Tony-Computer-Science/IoT-Security-Gateway/docs/assets/s3-test/hardware-events.png

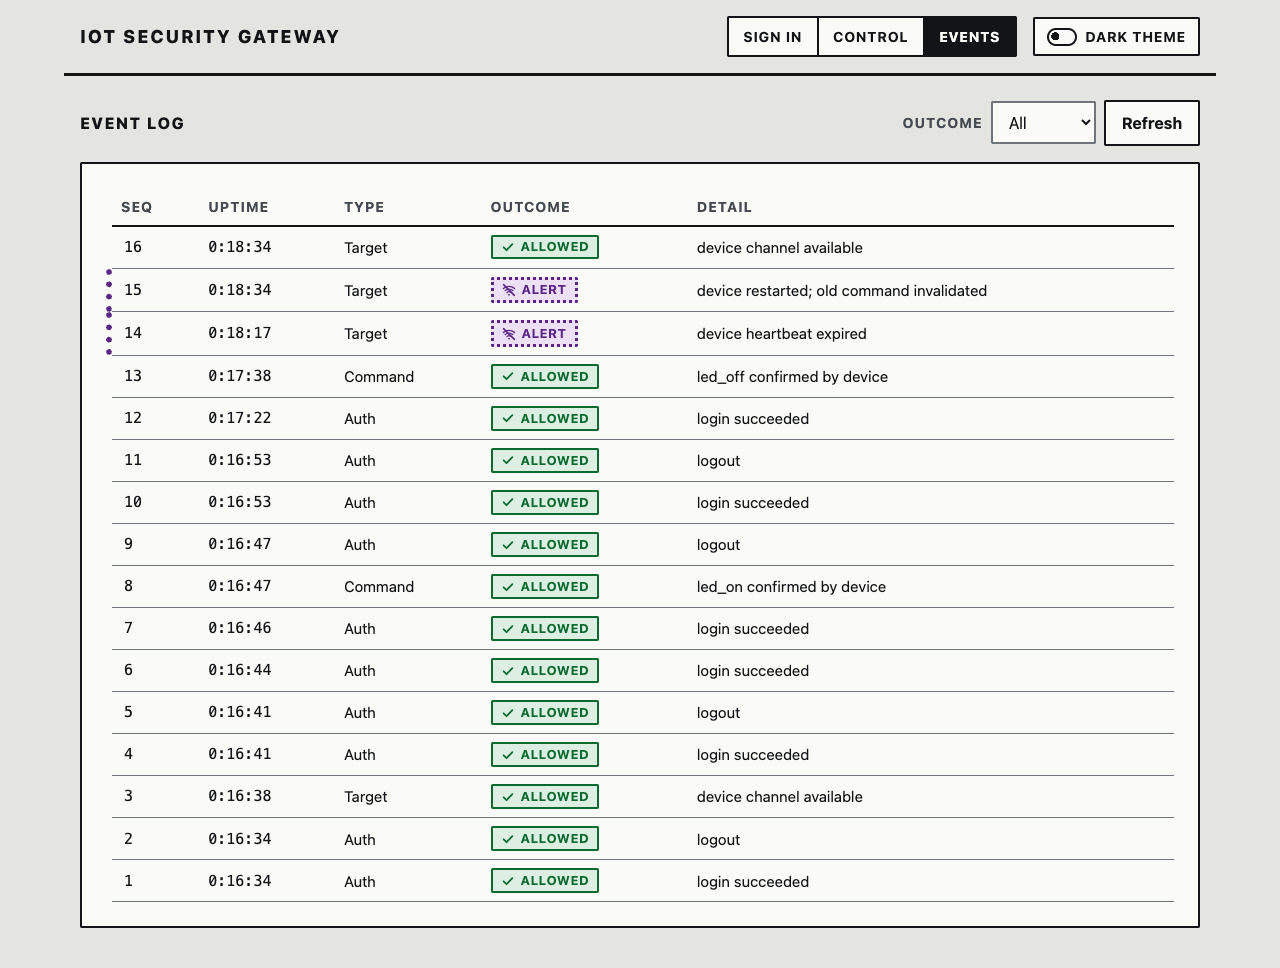
docs/assets/s3-test/hardware-events.png
