Tony-Computer-Science/IoT-Security-Gateway/docs/assets/s3-test/hardware-heartbeat-expired.png

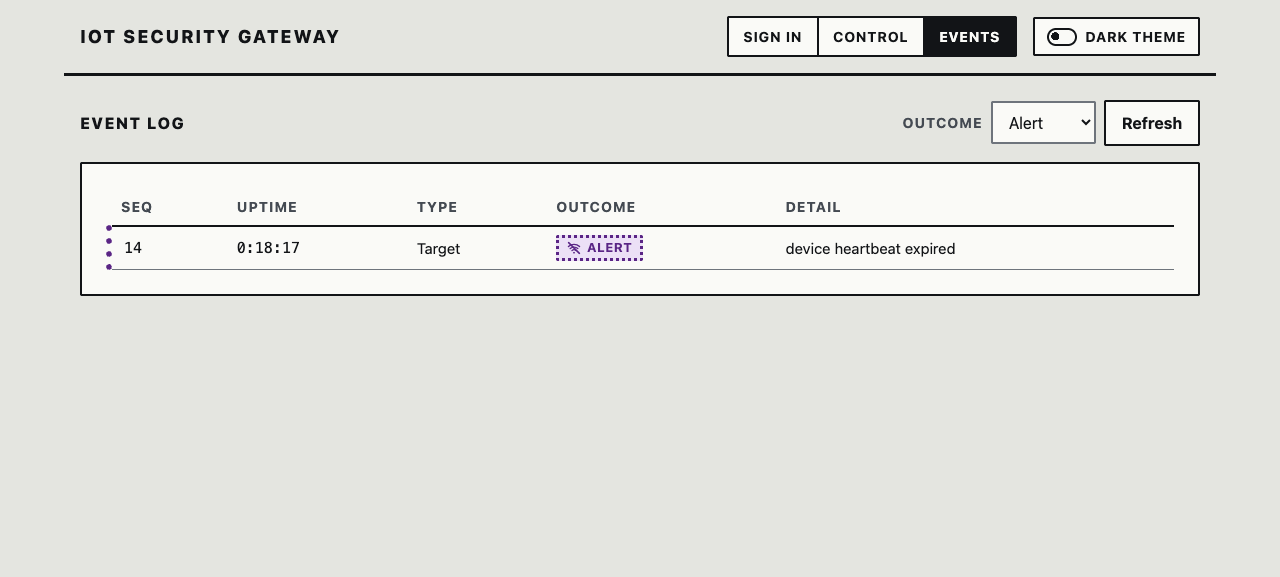
docs/assets/s3-test/hardware-heartbeat-expired.png
