Tony-Computer-Science/IoT-Security-Gateway/docs/assets/s3-test/hardware-online.png

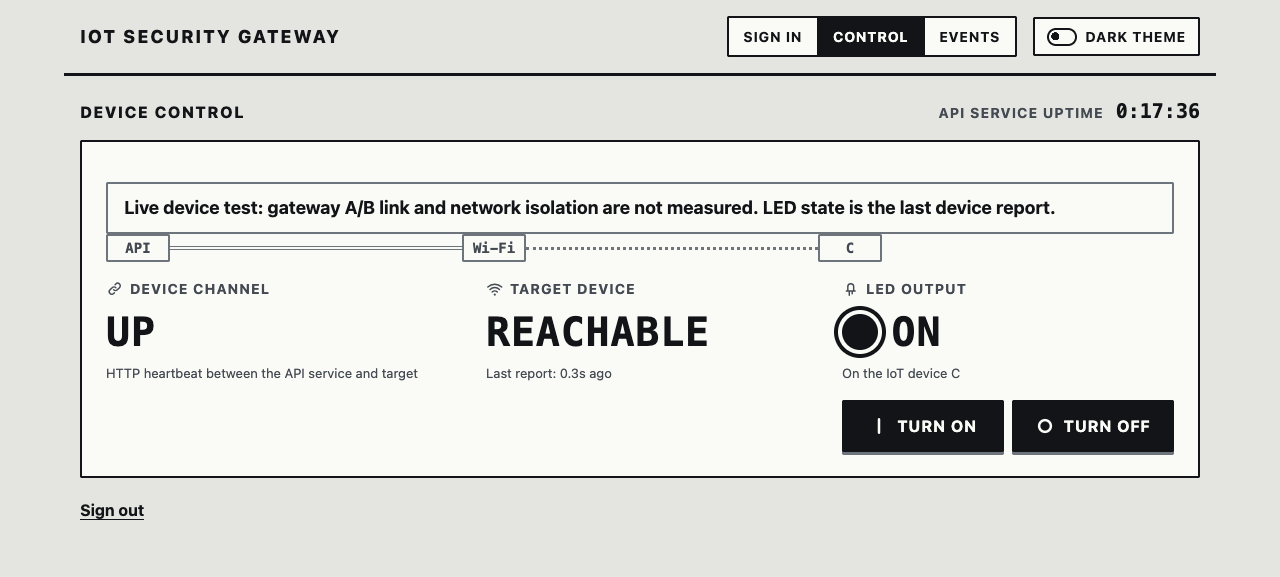
docs/assets/s3-test/hardware-online.png
