Tony-Computer-Science/IoT-Security-Gateway/docs/assets/s3-test/live-monitoring-offline.png

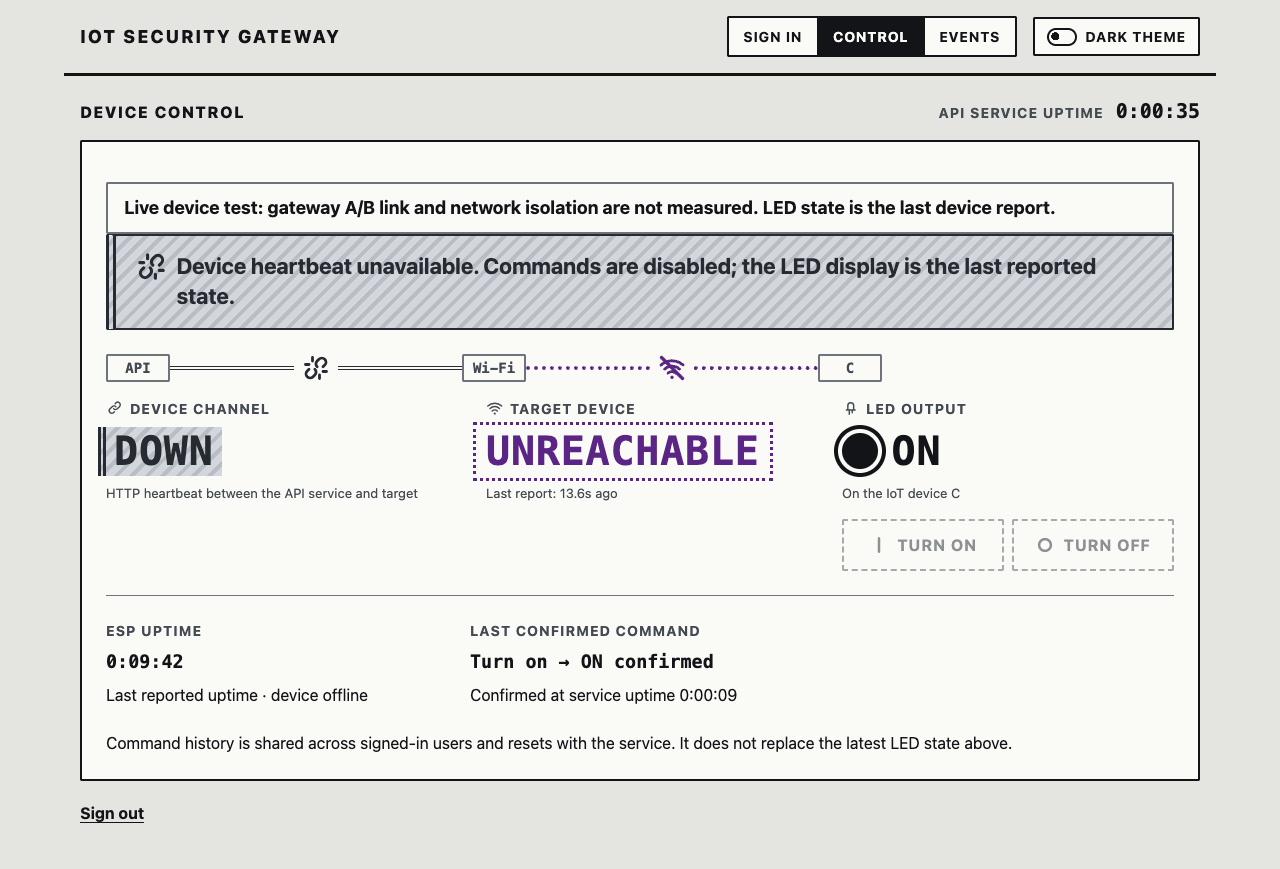
docs/assets/s3-test/live-monitoring-offline.png
