Tony-Computer-Science/IoT-Security-Gateway/docs/assets/s3-test/live-monitoring-restart.png

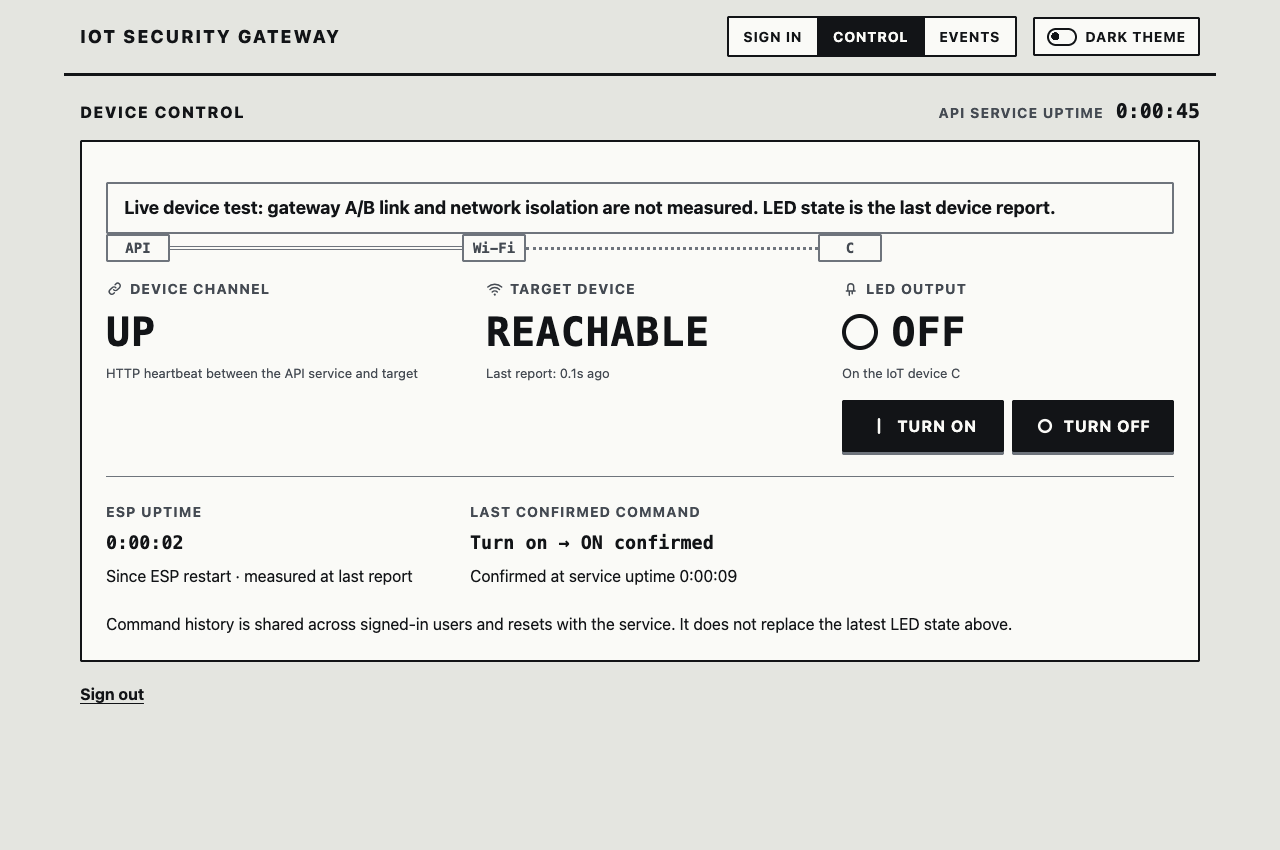
docs/assets/s3-test/live-monitoring-restart.png
