Tony-Computer-Science/IoT-Security-Gateway/hardware/kicad/IoT-Gateway.kicad_pcb

## KiCad design hardware/kicad/IoT-Gateway.kicad_pcb (2026-10-25)

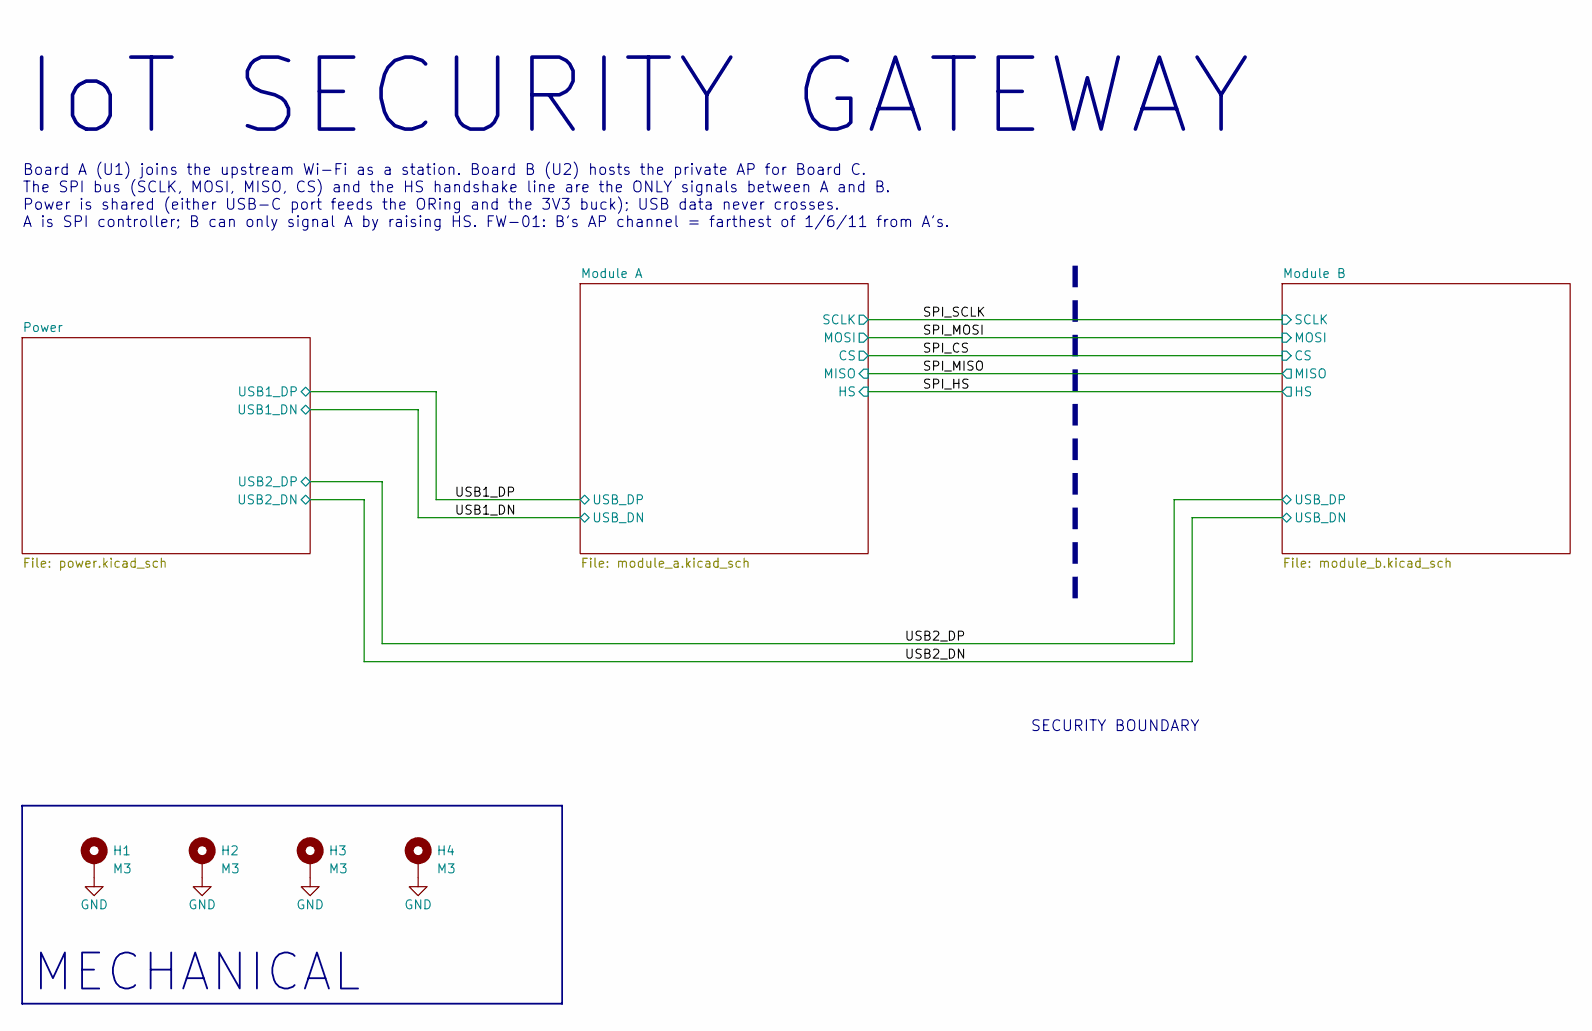
[picture p6: schematic IoT-Gateway.kicad_sch, IoT Security Gateway]

Parts:
H1, H2, H3, H4: M3; MountingHole_3.2mm_M3_Pad_Via

Connections:
GND: H1.1, H2.1, H3.1, H4.1; also elsewhere on the board

Notes on the sheet:
MECHANICAL
IoT SECURITY GATEWAY
Board A (U1) joins the upstream Wi-Fi as a station. Board B (U2) hosts the private AP for Board C. The SPI bus (SCLK, MOSI, MISO, CS) and the HS handshake line are the ONLY signals between A and B. Power is shared (either USB-C port feeds the ORing and the 3V3 buck); USB data never crosses. A is SP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
SECURITY BOUNDARY

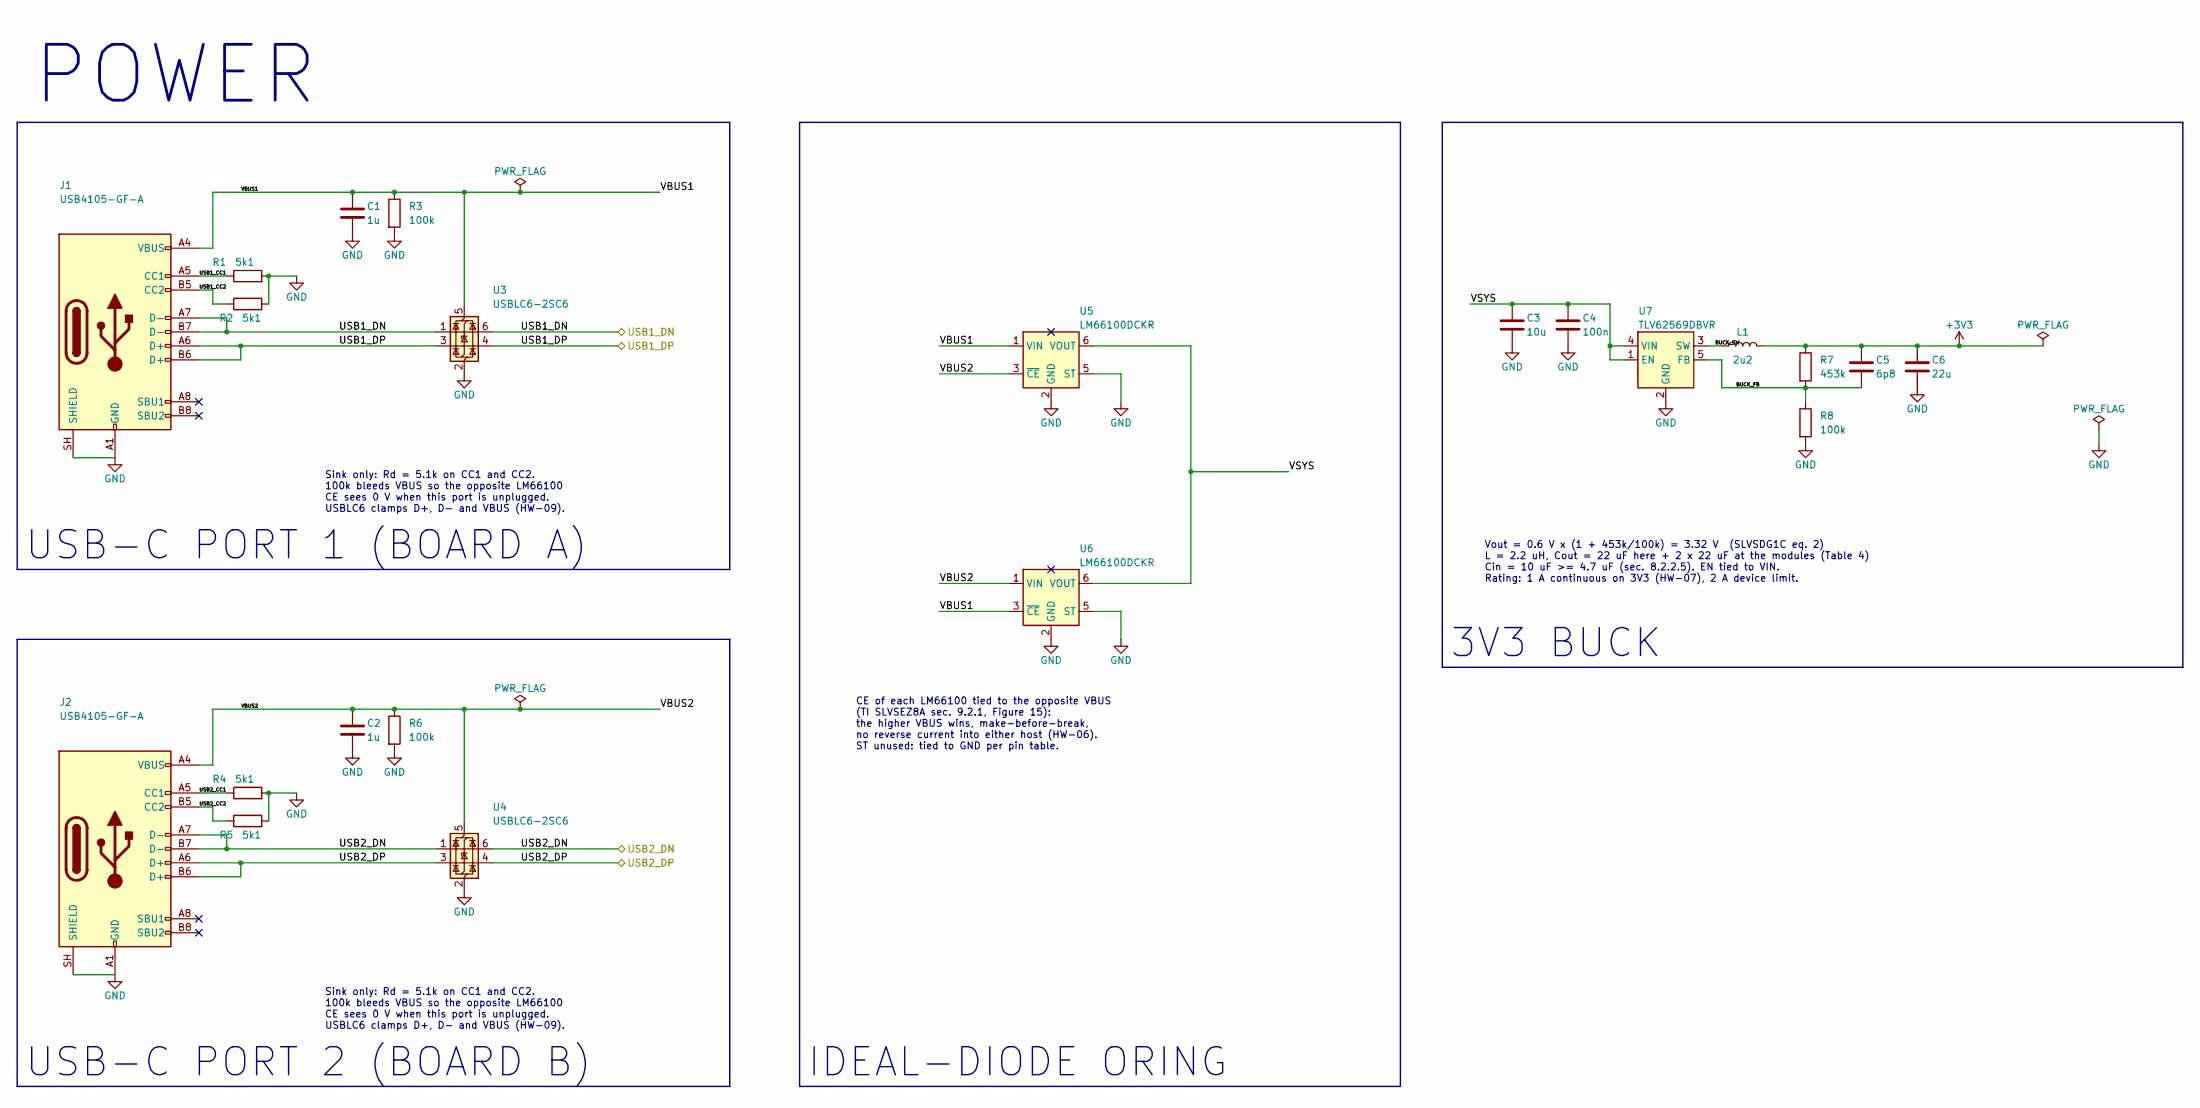
[picture p7: schematic power.kicad_sch, IoT Gateway - Power (USB-C, ORing, 3V3 buck)]

Parts:
C1, C2: 1u; C_0603_1608Metric
C3: 10u; C_0805_2012Metric
C4: 100n; C_0603_1608Metric
C5: 6p8; C_0603_1608Metric
C6: 22u; C_0805_2012Metric
J1, J2: USB4105-GF-A; USB_C_Receptacle_GCT_USB4105-xx-A_16P_TopMnt_Horizontal; Mfg Part # USB4105-GF-A
L1: 2u2; L_Coilcraft_XAL4020-XXX; Mfg Part # XAL4020-222ME
R1, R2, R4, R5: 5k1; R_0603_1608Metric
R3, R6, R8: 100k; R_0603_1608Metric
R7: 453k; R_0603_1608Metric
U3, U4: USBLC6-2SC6; SOT-23-6; Mfg Part # USBLC6-2SC6
U5, U6: LM66100DCKR; SOT-363_SC-70-6; Mfg Part # LM66100DCKR
U7: TLV62569DBVR; SOT-23-5; Mfg Part # TLV62569DBVR

Connections:
+3V3: C5.1, C6.1, L1.2, R7.1; also elsewhere on the board
/Power/BUCK_FB: C5.2, R7.2, R8.1, U7.5 (FB)
/Power/BUCK_SW: L1.1, U7.3 (SW)
/Power/USB1_CC1: J1.A5 (CC1), R1.1
/Power/USB1_CC2: J1.B5 (CC2), R2.1
/Power/USB2_CC1: J2.A5 (CC1), R4.1
/Power/USB2_CC2: J2.B5 (CC2), R5.1
/Power/VBUS1: C1.1, J1.A4 (VBUS), J1.A9 (VBUS), J1.B4 (VBUS), J1.B9 (VBUS), R3.1, U3.5 (VBUS), U5.1 (VIN), U6.3 (~CE)
/Power/VBUS2: C2.1, J2.A4 (VBUS), J2.A9 (VBUS), J2.B4 (VBUS), J2.B9 (VBUS), R6.1, U4.5 (VBUS), U5.3 (~CE), U6.1 (VIN)
/Power/VSYS: C3.1, C4.1, U5.6 (VOUT), U6.6 (VOUT), U7.1 (EN), U7.4 (VIN)
/USB1_DN: J1.A7 (D-), J1.B7 (D-), U3.1 (I/O1), U3.6 (I/O1); also elsewhere on the board
/USB1_DP: J1.A6 (D+), J1.B6 (D+), U3.3 (I/O2), U3.4 (I/O2); also elsewhere on the board
/USB2_DN: J2.A7 (D-), J2.B7 (D-), U4.1 (I/O1), U4.6 (I/O1); also elsewhere on the board
/USB2_DP: J2.A6 (D+), J2.B6 (D+), U4.3 (I/O2), U4.4 (I/O2); also elsewhere on the board
GND: C1.2, C2.2, C3.2, C4.2, C6.2, J1.A1 (GND), J1.A12 (GND), J1.B1 (GND), J1.B12 (GND), J1.SH (SHIELD), J2.A1 (GND), J2.A12 (GND), J2.B1 (GND), J2.B12 (GND), J2.SH (SHIELD), R1.2, R2.2, R3.2, R4.2, R5.2, R6.2, R8.2, U3.2 (GND), U4.2 (GND), U5.2 (GND), U5.5 (ST), U6.2 (GND), U6.5 (ST), U7.2 (GND); also elsewhere on the board

Notes on the sheet:
USB-C PORT 1 (BOARD A)
Sink only: Rd = 5.1k on CC1 and CC2. 100k bleeds VBUS so the opposite LM66100 CE sees 0 V when this port is unplugged. USBLC6 clamps D+, D- and VBUS (HW-09).
USB-C PORT 2 (BOARD B)
IDEAL-DIODE ORING
CE of each LM66100 tied to the opposite VBUS (TI SLVSEZ8A sec. 9.2.1, Figure 15): the higher VBUS wins, make-before-break, no reverse current into either host (HW-06). ST unused: tied to GND per pin table.
3V3 BUCK
Vout = 0.6 V x (1 + 453k/100k) = 3.32 V (SLVSDG1C eq. 2) L = 2.2 uH, Cout = 22 uF here + 2 x 22 uF at the modules (Table 4) Cin = 10 uF >= 4.7 uF (sec. 8.2.2.5). EN tied to VIN. Rating: 1 A continuous on 3V3 (HW-07), 2 A device limit.
POWER

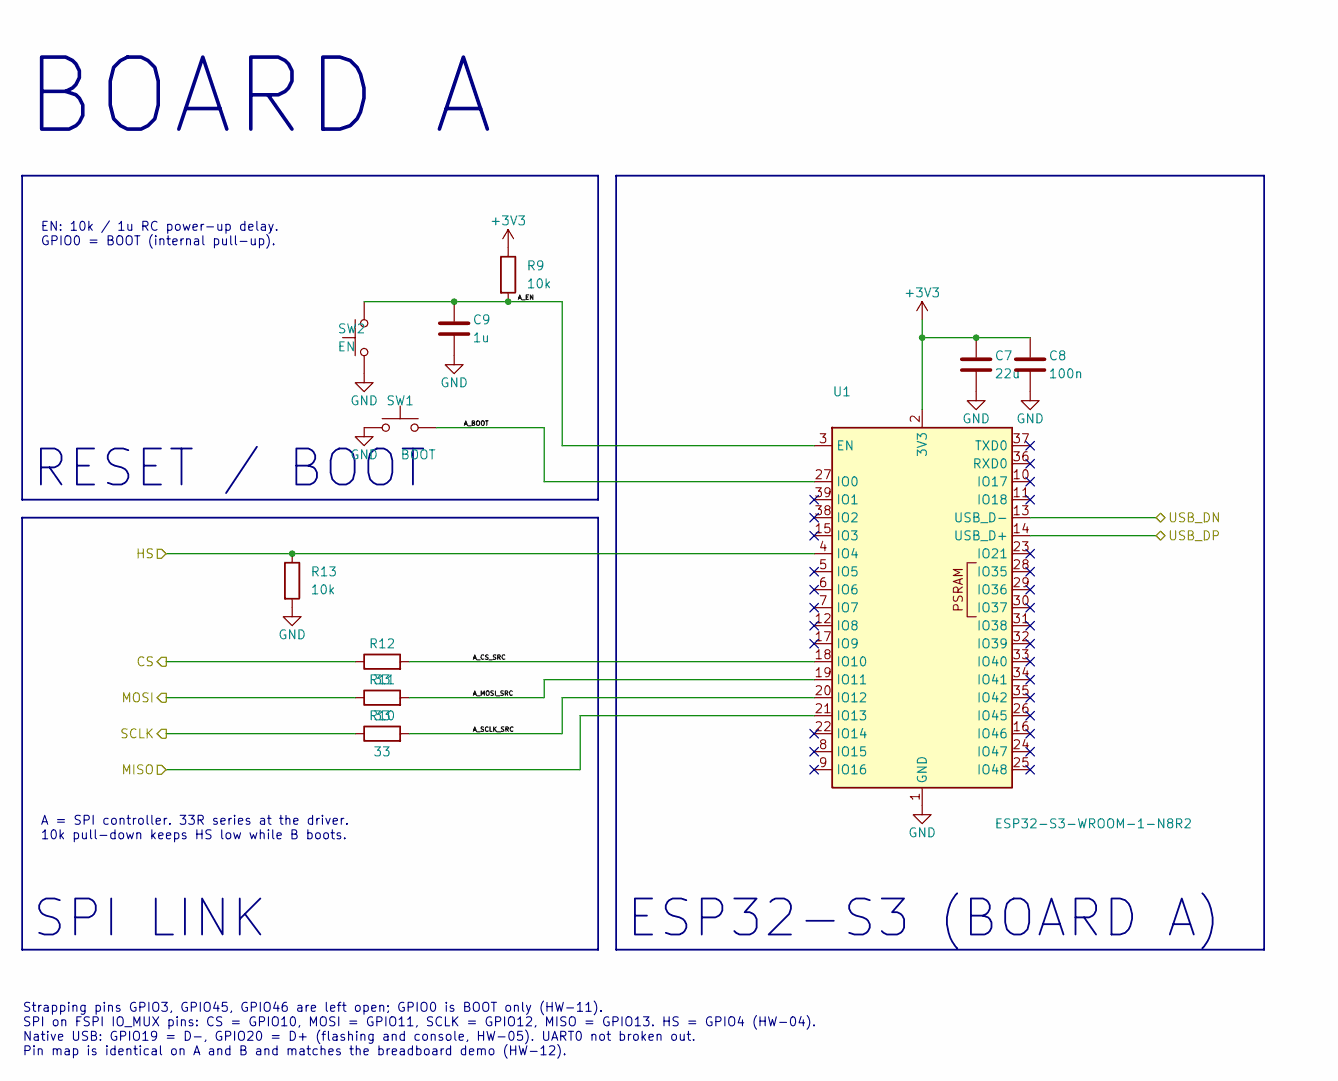
[picture p8: schematic module_a.kicad_sch, IoT Gateway - Board A (SPI controller, uplink STA)]

Parts:
C7: 22u; C_0805_2012Metric
C8: 100n; C_0603_1608Metric
C9: 1u; C_0603_1608Metric
R9, R13: 10k; R_0603_1608Metric
R10, R11, R12: 33; R_0603_1608Metric
SW1: BOOT; SW_SPST_B3U-1000P
SW2: EN; SW_SPST_B3U-1000P
U1: ESP32-S3-WROOM-1-N8R2; ESP32-S3-WROOM-1; Mfg Part # ESP32-S3-WROOM-1-N8R2

Connections:
+3V3: C7.1, C8.1, R9.1, U1.2 (3V3); also elsewhere on the board
/Module A/A_BOOT: SW1.2, U1.27 (IO0)
/Module A/A_CS_SRC: R12.2, U1.18 (IO10)
/Module A/A_EN: C9.1, R9.2, SW2.2, U1.3 (EN)
/Module A/A_MOSI_SRC: R11.2, U1.19 (IO11)
/Module A/A_SCLK_SRC: R10.2, U1.20 (IO12)
/SPI_CS: R12.1; also elsewhere on the board
/SPI_HS: R13.1, U1.4 (IO4); also elsewhere on the board
/SPI_MISO: U1.21 (IO13); also elsewhere on the board
/SPI_MOSI: R11.1; also elsewhere on the board
/SPI_SCLK: R10.1; also elsewhere on the board
/USB1_DN: U1.13 (USB_D-); also elsewhere on the board
/USB1_DP: U1.14 (USB_D+); also elsewhere on the board
GND: C7.2, C8.2, C9.2, R13.2, SW1.1, SW2.1, U1.1 (GND), U1.40 (GND), U1.41 (GND); also elsewhere on the board

Notes on the sheet:
ESP32-S3 (BOARD A)
RESET / BOOT
EN: 10k / 1u RC power-up delay. GPIO0 = BOOT (internal pull-up).
SPI LINK
A = SPI controller. 33R series at the driver. 10k pull-down keeps HS low while B boots.
Strapping pins GPIO3, GPIO45, GPIO46 are left open; GPIO0 is BOOT only (HW-11). SPI on FSPI IO_MUX pins: CS = GPIO10, MOSI = GPIO11, SCLK = GPIO12, MISO = GPIO13. HS = GPIO4 (HW-04). Native USB: GPIO19 = D-, GPIO20 = D+ (flashing and console, HW-05). UART0 not broken out. Pin map is identical on A 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
BOARD A

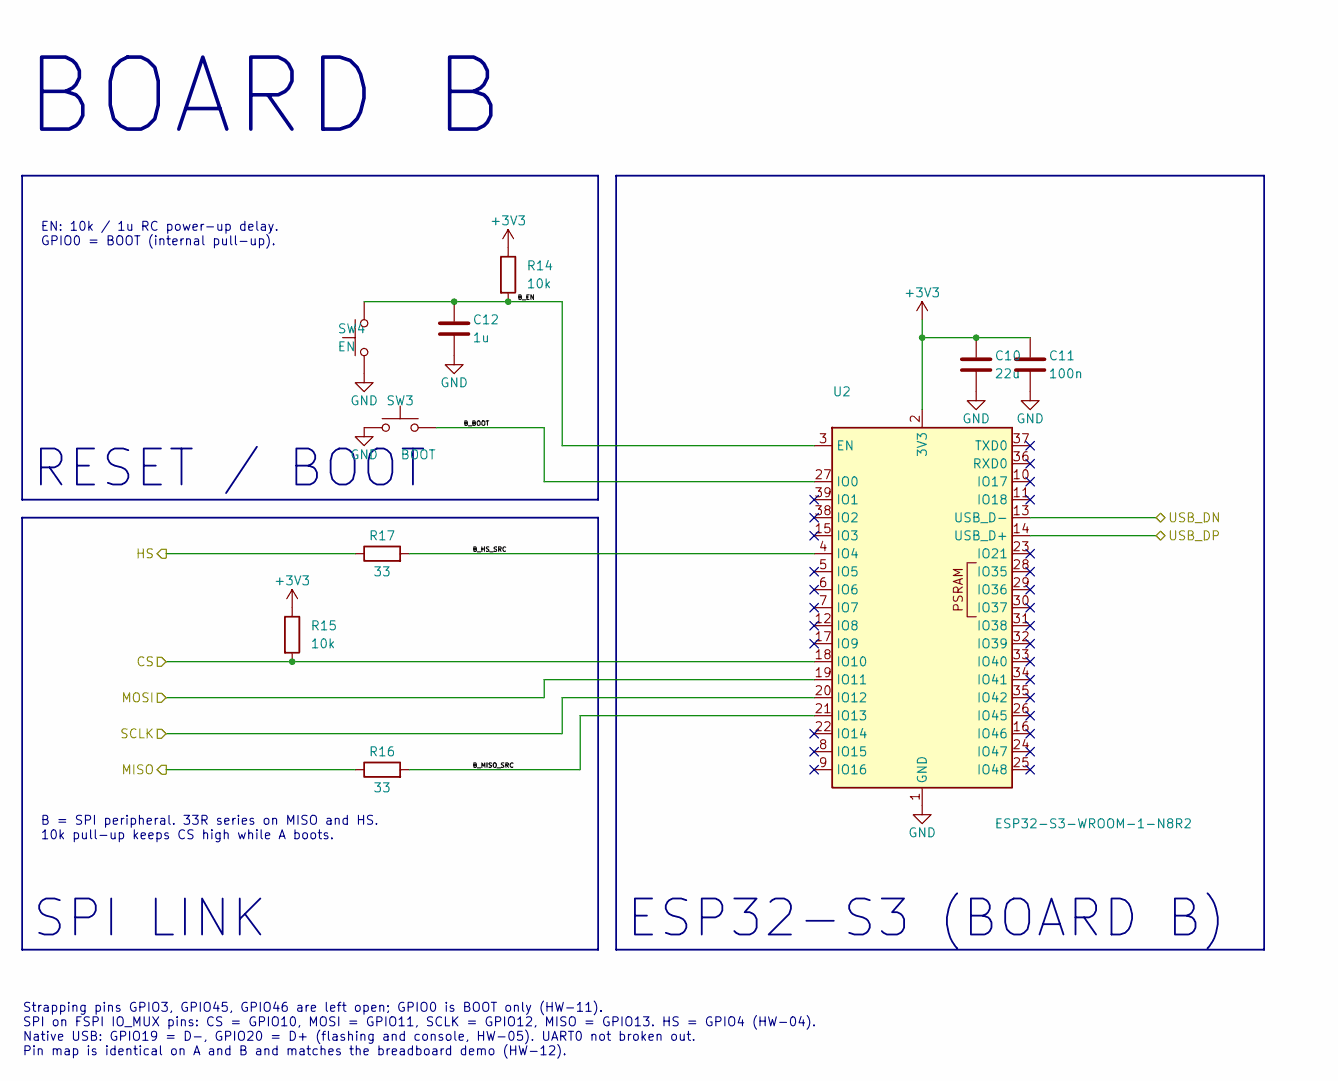
[picture p9: schematic module_b.kicad_sch, IoT Gateway - Board B (SPI peripheral, private AP)]

Parts:
C10: 22u; C_0805_2012Metric
C11: 100n; C_0603_1608Metric
C12: 1u; C_0603_1608Metric
R14, R15: 10k; R_0603_1608Metric
R16, R17: 33; R_0603_1608Metric
SW3: BOOT; SW_SPST_B3U-1000P
SW4: EN; SW_SPST_B3U-1000P
U2: ESP32-S3-WROOM-1-N8R2; ESP32-S3-WROOM-1; Mfg Part # ESP32-S3-WROOM-1-N8R2

Connections:
+3V3: C10.1, C11.1, R14.1, R15.1, U2.2 (3V3); also elsewhere on the board
/Module B/B_BOOT: SW3.2, U2.27 (IO0)
/Module B/B_EN: C12.1, R14.2, SW4.2, U2.3 (EN)
/Module B/B_HS_SRC: R17.2, U2.4 (IO4)
/Module B/B_MISO_SRC: R16.2, U2.21 (IO13)
/SPI_CS: R15.2, U2.18 (IO10); also elsewhere on the board
/SPI_HS: R17.1; also elsewhere on the board
/SPI_MISO: R16.1; also elsewhere on the board
/SPI_MOSI: U2.19 (IO11); also elsewhere on the board
/SPI_SCLK: U2.20 (IO12); also elsewhere on the board
/USB2_DN: U2.13 (USB_D-); also elsewhere on the board
/USB2_DP: U2.14 (USB_D+); also elsewhere on the board
GND: C10.2, C11.2, C12.2, SW3.1, SW4.1, U2.1 (GND), U2.40 (GND), U2.41 (GND); also elsewhere on the board

Notes on the sheet:
ESP32-S3 (BOARD B)
RESET / BOOT
EN: 10k / 1u RC power-up delay. GPIO0 = BOOT (internal pull-up).
SPI LINK
B = SPI peripheral. 33R series on MISO and HS. 10k pull-up keeps CS high while A boots.
Strapping pins GPIO3, GPIO45, GPIO46 are left open; GPIO0 is BOOT only (HW-11). SPI on FSPI IO_MUX pins: CS = GPIO10, MOSI = GPIO11, SCLK = GPIO12, MISO = GPIO13. HS = GPIO4 (HW-04). Native USB: GPIO19 = D-, GPIO20 = D+ (flashing and console, HW-05). UART0 not broken out. Pin map is identical on A 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
BOARD B

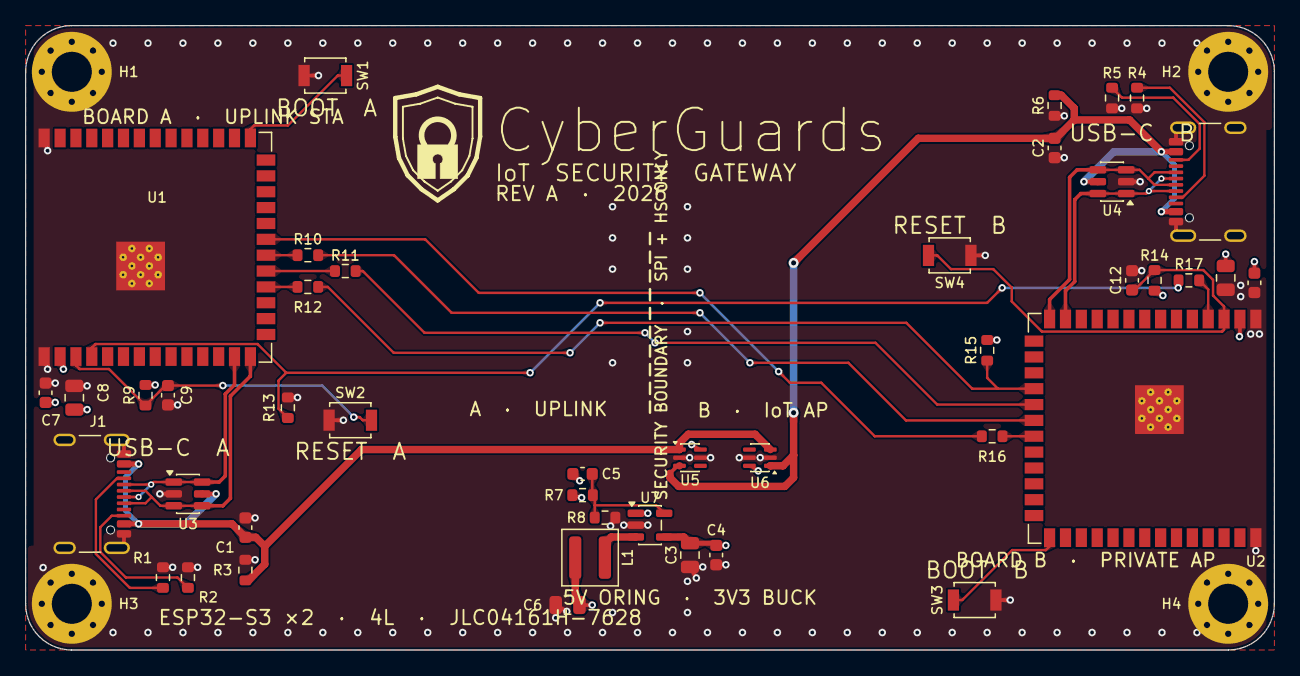
[picture p10: board IoT-Gateway.kicad_pcb from above]

Board: 4 copper layers, 100.0 x 50.0 mm, 47 parts (0 on the bottom side), 29 nets.
