Tony-Computer-Science/IoT-Security-Gateway/firmware/bridge-board/components/bridge_router/include/gateway_lwip_hooks.h

#pragma once
struct pbuf;
struct netif;
int gateway_ip4_input(struct pbuf *packet, struct netif *input);
int gateway_ip4_canforward(struct pbuf *packet, unsigned int destination);
#define LWIP_HOOK_IP4_INPUT(p, n) gateway_ip4_input(p, n)
#define LWIP_HOOK_IP4_CANFORWARD(p, d) gateway_ip4_canforward(p, d)
