Tony-Computer-Science/IoT-Security-Gateway/(commit log)

2026-10-11 docs: add architecture, requirements, API contract, SPI stub
    requirements.md records R1-R7 verbatim. api-contract.md is v0.1.0 with
    common R3 errors (400/404/405/413) and open questions. spi-protocol.md
    is a stub with every undecided item marked TODO.
2026-10-11 web: scaffold interface, API client, and mock server
    Three view shells, design tokens and six non-color-only state styles,
    api.js with one function per endpoint and an in-memory token, app.js
    with view switching and the polling skeleton (rendering left as TODO).
    Stdlib mock server implements the v0.1.0 contract with failure
    injection via /__mock/state and /__mock/reset.
2026-10-11 firmware: scaffold station, bridge, and target ESP-IDF projects
    ESP-IDF v5.x skeletons for all three boards. main.c only logs a banner.
    Station board splits into net_station, auth, policy, eventlog, spi_host;
    bridge board into spi_device, ap_mode, target_client. Every component is
    a stub returning ESP_ERR_NOT_SUPPORTED. partitions.csv adds a LittleFS
    www partition with offsets left to the tool.
    [partitions.csv]
2026-10-11 tools: add web build and LittleFS scripts, test plan layout
    build.py minifies and gzips web/src in pure Python, prints a size
    report, and fails over the 60 KB budget or on forbidden APIs.
    mklittlefs.sh packs web/dist sized from partitions.csv.
2026-10-24 web: add session expiry timer and view guard
    showView() now redirects to login unless a token is held and its
    expires_in deadline has not passed. The token stays in api.js memory
    only (R2); app.js tracks just the expiry time.
2026-10-24 web: implement login view with lockout countdown
    Submit is handled in JS (preventDefault, no page reload). Success starts
    the session expiry timer and switches to control. 401 shows the denied
    state with attempts_remaining. 429 shows the rate-limited state, disables
    submit, and counts down retry_after from a fixed deadline. The guard now
    expires a session whose deadline passed before its timer fired.
2026-10-25 web: make status polling overlap-proof and pausable
    One timer and one in-flight request at most. Ticks that find a poll or
    command in flight are skipped. The visibilitychange handler no longer
    restarts the loop, which could start a second poll chain while a poll
    was still in flight.
2026-10-25 web: add command result slot and clearer control view labels
    Separate message slots for gateway health and the last command result.
    Command buttons start disabled until a status poll reports the link and
    target are up (R7).
2026-10-25 web: implement control view without optimistic updates
    The displayed LED state changes only on a 200 from /api/command or a
    status poll, never on click (R6, R7). Commands show pending while in
    flight and pause polling; a command waits for any in-flight poll so
    requests never overlap. Each error maps to its state style: 400/403
    denied, 429 countdown with both controls disabled, 502 names the target
    device, 503 names the board-to-board link, 401 returns to login. Failed
    polls keep the last known state on screen. Adds sign out.
2026-10-25 web: make disabled buttons visibly disabled
    The old :disabled rule applied opacity 0.55 but kept the accent fill, so
    disabled command buttons still read as active. Disabled buttons now use
    a --disabled-opacity token, drop the accent fill, and get a dashed
    border, and the rule is ordered after the accent rule so it always wins.
2026-10-25 PCB rev A
    [IoT-Gateway.kicad_pcb, IoT-Gateway.kicad_sch, module_a.kicad_sch, module_b.kicad_sch, power.kicad_sch]
2026-11-01 web: let the poll loop run the active view's refresh task
    startPolling now takes the task to run each tick (status by default),
    so every view shares one timer and one in-flight slot instead of adding
    its own. Results from a task that was stopped or replaced are dropped.
    An immediate poll that finds a request in flight now runs as soon as
    that request finishes instead of waiting a full interval.
2026-11-01 web: add events view error and empty-state slots, compact badges
    Adds #events-state for refresh errors and #events-empty for an empty log.
    Outcome badges in the table reuse the existing .state styles, sized down
    for a table cell; no new state style is added. Browser scroll anchoring
    is disabled on the table because the view restores position itself.
2026-11-01 web: implement events view on the shared poll loop
    Shows the bounded event log (R5) newest first with seq, readable
    uptime, type, an outcome badge using the existing state styles, and the
    detail text (textContent only). The outcome filter is applied by the
    gateway via ?outcome=. Refreshes run as the shared loop's task every
    2000 ms, so they never overlap a status poll. Failed refreshes keep the
    last list and show the error beside it; 401 returns to login. Empty
    results show an explicit empty state, unchanged results skip the redraw,
    and redraws keep the reader's row in place when scrolled.
2026-11-01 web: expose confirmed status as data-value for styling
    Three presentational lines in renderShown() set data-value on the LED,
    target, and link readouts so CSS can draw the LED lamp and the signal
    path. They read only the confirmed state from gateway responses, never
    the requested action, so they cannot become an optimistic update (R7).
    No behaviour, API, polling, or state logic changes.
2026-11-01 web: restructure views around the A-B-C signal path
    The control view's readouts now sit on a diagram of the hardware path
    (SPI wire between A and B, Wi-Fi hop between B and C), so a failure
    appears on the segment that broke. Adds five hand-written inline SVG
    icons (aria-hidden, always next to text): wire link, Wi-Fi, LED, and the
    IEC on/off symbols on the command keys. Every id and selector the script
    uses is unchanged.
2026-11-01 web: instrument-panel styling tuned for projection
    One light theme (automatic dark mode removed) with high-contrast ink on a
    light faceplate. Large mono readouts, spaced capital labels, dark keycaps,
    and a blue reserved for the focus ring. The six states keep distinct
    icons and patterns that survive grayscale; their glyphs are hand-written
    SVG data URIs drawn through mask-image. Failed hops break the wire and
    show the state icon, the LED lamp follows confirmed state, and readouts
    show HOLD when a poll fails. Path turns vertical in narrow windows; the
    pending pulse and key travel are the only motion and respect
    prefers-reduced-motion.
2026-11-01 docs: tighten web design rationale to one page
2026-11-01 web: regroup control view into one-label one-value readouts
    Each segment is now one unit: a single label, the value, and the medium
    as small print beneath. All three values share one size, weight, and
    baseline (CSS subgrid). The LED readout has the same weight as the
    others and its keys and command result sit directly under it. The health
    message moves to the top of the panel. The A-B-C strip shrinks to small
    grey boxes and thin wires so it recedes, and still breaks with the state
    icon on the failed hop. State treatments are unchanged.
2026-11-01 web: add a manual dark theme toggle, light on every load
    A header switch flips data-theme between light and dark. Light is the
    default on every page load because the demo is projected and light was
    tested for that. The choice is deliberately not saved (no storage, no
    cookie), so a reload always returns to light. The dark palette keeps each
    state's icon and pattern; only colours change.
2026-11-01 web: resolve LittleFS geometry in mklittlefs.sh
    Block size 4096 comes from esp_littlefs (src/esp_littlefs.c, fixed for
    ESP32 flash) and matches its own CMake image builder. Page size 256 is
    the Kconfig default; mklittlefs 4.1.0 parses -p but does not use it.
    Documents why the 255-character name limit mklittlefs records still
    mounts. Refuses to pack a dist/ that contains non-gzipped files.
    Tested with mklittlefs 4.1.0 from Homebrew.
2026-11-01 web: add LittleFS image verifier
    verify_littlefs.py mounts an image with esp_littlefs's geometry and
    checks it holds exactly the files in web/dist, byte for byte, plus the
    partition size and superblock. Never formats or writes the image. Uses
    littlefs-python 0.15.0, the version esp_littlefs uses for idf.py builds,
    so it checks images from both build paths.
2026-11-01 web: document both LittleFS build paths, flashing, and 8 MB proposal
    Path A (standalone mklittlefs, brew on macOS) and path B (esp_littlefs
    littlefs_create_partition_image during idf.py build), which file each
    produces, and how they differ. Step-by-step flashing of the www
    partition with parttool.py or esptool. Proposed partition sizes for the
    confirmed 8 MB WROOM-1-N8R2 module and the sdkconfig.defaults flash size
    update, written for the station board owner and not applied.
2026-11-01 docs: explain how the web assets get onto the board
2026-11-02 tools: add evaluation and attack suite covering R1-R7
    One script per test case under the four test-plan categories, standard
    library only, credentials from GATEWAY_USER and GATEWAY_PASSWORD, and a
    shared common.py that follows the REST API contract v0.1.0.
    run_all.py runs every case and exits non-zero on any failure.
    [common.py]
2026-11-02 docs: add the evaluation test plan with recorded mock results
    Records the four test categories, the method, the mock baseline run of
    2026-11-02 (18 of 19 case scripts pass), the one deviation found in the mock,
    and how the tables map into section V of the final report.
2026-11-07 web: match control view topology to the hardware
    The diagram now reads B, A, C: bridge board B joins the upstream Wi-Fi,
    a UART wire runs to station board A, and A creates the private Wi-Fi
    "IoT-Gateway" that IoT device C joins. Sub-labels name UART and the
    correct boards. Link-down messages name the UART wire; target-unreachable
    messages name the station board. Text, labels and box order only; no
    state, polling or behaviour changes.
2026-11-07 docs: update web notes for the B-UART-A-Wi-Fi-C topology
2026-11-07 target: connect S3 test firmware to the current web interface
    Reuse Board C protocol and device service from the router branch at 653a152. Preserve main login, control and events pages while adding S3 configuration and accurate heartbeat/service labels. Cover unknown initial state and event-only expiry. Supports R6/R7 UI validation without claiming A/B gateway isolation.
2026-11-08 web: show device uptime and confirmed command history
2026-11-08 Update KiCad installation instructions
    Removed TODO note about agreeing on a team version of KiCad.
2026-11-08 Update README.md by removing Board C details
    Removed details about Board C and TODO items related to wiring diagram and bring-up checklist.
2026-11-08 service: report device failures distinctly and reserve device capacity
    A device that acknowledged a command but reported ack_ok=false or a
    different output was shown as "unconfirmed", the same as a lost ACK. The
    service now returns 502 command_failed with the device's reported output
    and logs it as a command alert; 504 command_unconfirmed is kept for
    delivered commands with no matching acknowledgement. The UI names the
    device's report instead of claiming the LED was unchanged, because a
    negative driver ACK is not optical proof.
    Browser/API requests shared all 16 worker slots with device polls, so a
    burst of browser traffic could stop the device checking in. Browser and
    API requests now use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
    [test_device_server.py]
2026-11-08 ci: run browser client and firmware parser tests
    Add dependency-free node:test coverage for web/src/api.js: bearer token
    handling, session loss on 401, the status/body to ErrorCode mapping
    (including command_failed and server_busy), transport failures and
    malformed bodies. app.js screen behavior still relies on manual browser
    checks.
    ci/run.sh now also runs these tests and the firmware parser tests. When
    no ESP-IDF build has installed managed cJSON, the parser runner downloads
    the pinned espressif/cjson 1.7.19~2 archive and verifies the archive and
    source hashes. macOS runs use UBSan only because the local ASan runtime
    hangs before main; Linux runs both sanitizers. The hosted workflow pins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
    [run_target_tests.py]
2026-11-08 Implement SPI/UART gateway and fixed-IP PC UI (#6)
    * firmware: implement dual-board Wi-Fi routing over SPI
    Add Board A WPA2/AES AP, DHCP/DNS propagation and client NAPT, plus Board B
    WPA2/WPA3 station uplink and NAPT. Share the version 0.2.0 Ethernet/SPI
    transport, session recovery, bounded queues and pre-NAT IPv4 policy.
    Include an isolated Board A test image, host protocol/policy regression
    tests, lab echo tooling, configuration guides and hardware acceptance steps.
    Affects R1-R7: preserve the original requirements verbatim and document the
    intentional incompatibility with their command-only architecture. This
    router milestone does not claim compliance with the original design.
    Validat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
    [partitions.csv]
2026-11-08 service: log every refused browser request as an event
    The device service overrides the mock's command handling and dropped its
    logging: invalid actions, rate-limited commands, a second command while
    one is in flight, and commands refused because the device is offline all
    returned errors without an event. Malformed or oversized command and
    login bodies were also silent. The Events view therefore could not show
    blocked attempts (R5).
    Each refused or failed request now writes exactly one event. Details
    name only the validated action and never echo client input. Delivery
    failures now say which command was not delivered or not acknowledged
    instead of a generic target alert. 503 server_busy refu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
    [test_device_server.py]
2026-11-08 monitoring: check the gateway live and show five-minute timelines
    Task 33 asks for live monitoring of the gateway, but the dashboard could
    only see Board C's heartbeat. Board A's forwarding policy makes the
    gateway observable from the PC without firmware changes: A always
    answers pings on its AP address, and client traffic to outside addresses
    passes only while the A-B link is ready and Board B's upstream works.
    The service now pings Board A every 2 s and opens a TCP connection to an
    outside IPv4:port every 5 s. A check turns down after two consecutive
    failures and up after one success; each transition is logged as a new
    gateway event. status.monitoring reports both checks and the device
    he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
    [test_gateway_monitor.py]
